travisg/6809obc/eagle/6809-layout.pdf

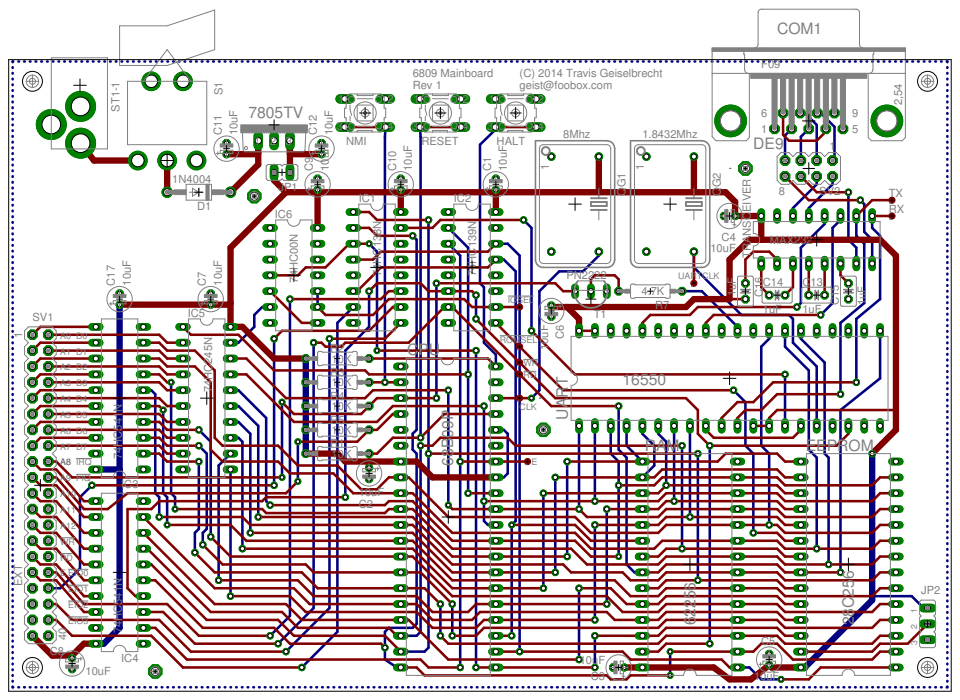
[picture p1: page 1]

R2
10K
R4
R5
