travisg/6809obc/eagle/6809-sch.pdf

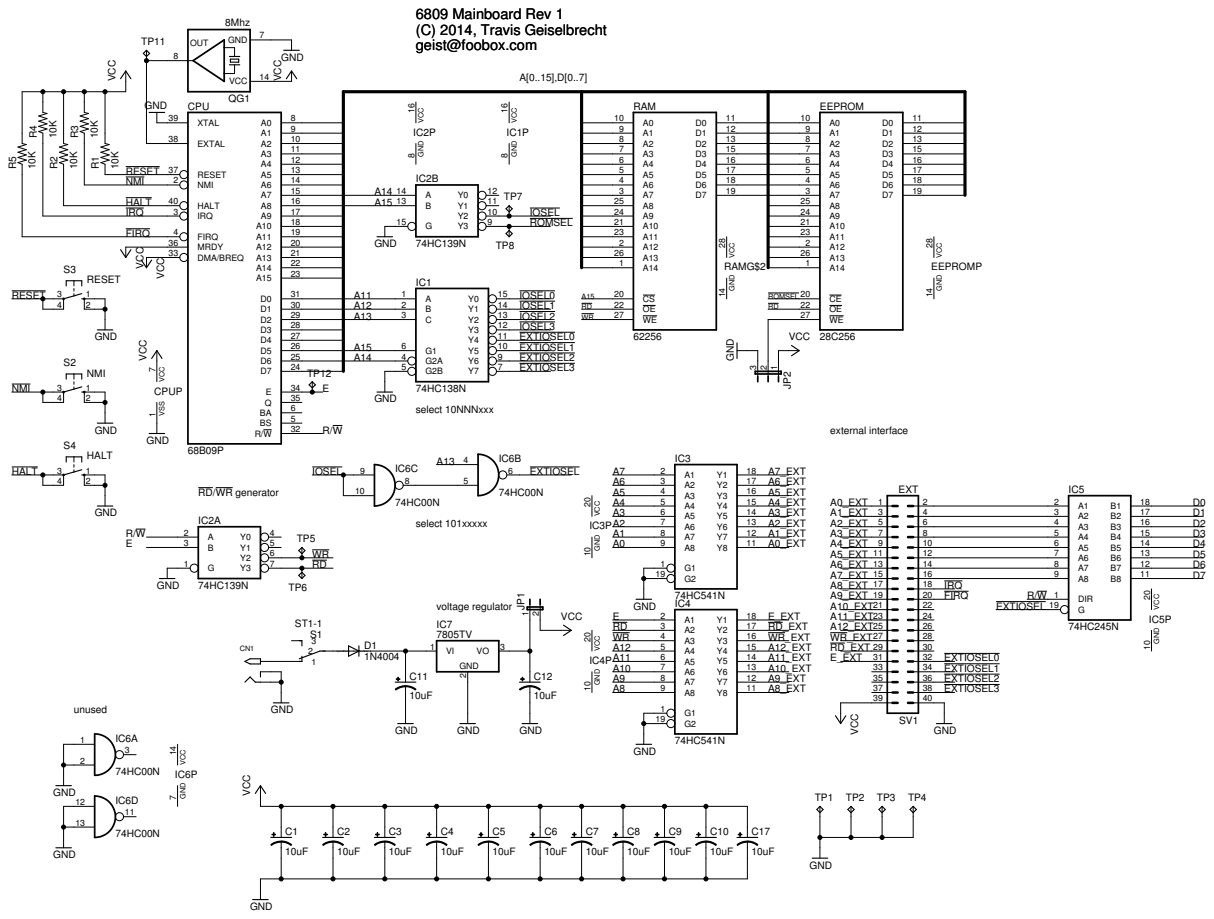
[picture p2: page 1]

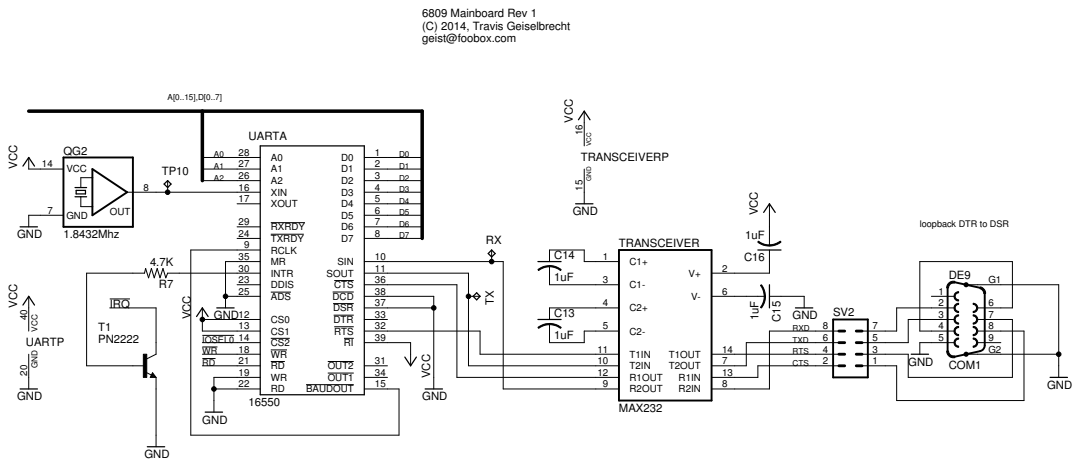
[picture p3: page 2]
