travisg/6809obc/eagle/6809.brd

## EAGLE design eagle/6809.brd (2014-07-19)

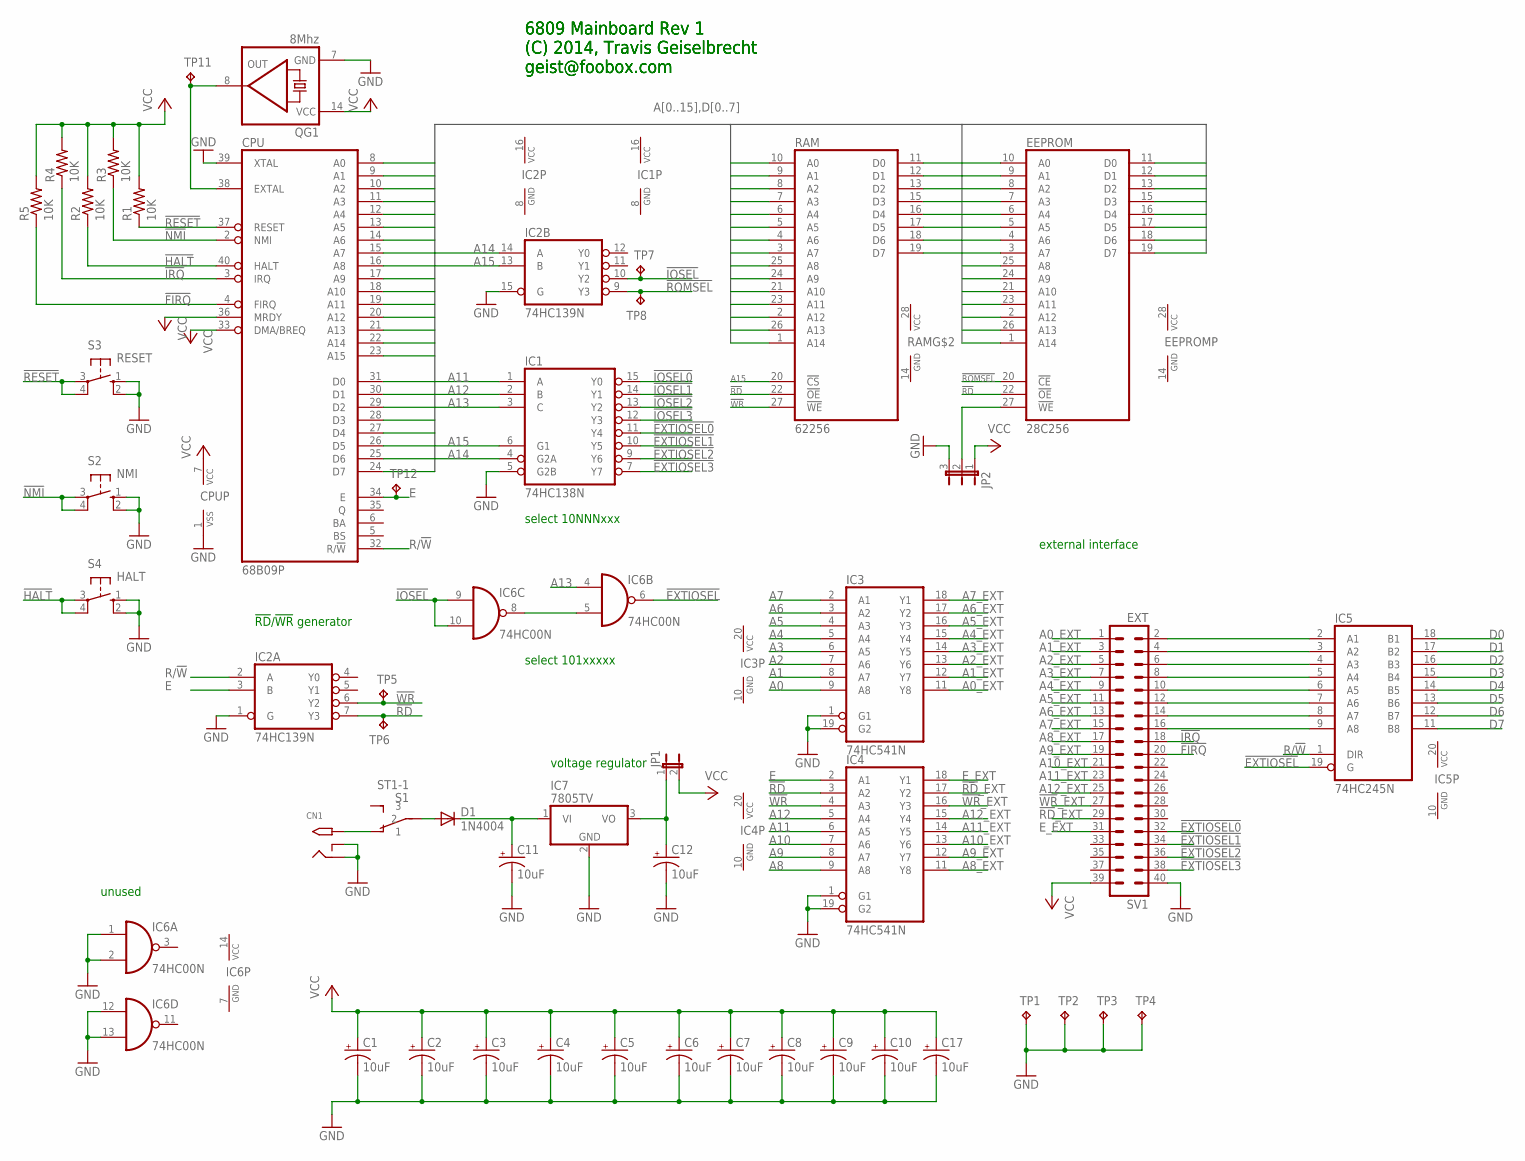
[picture p4: schematic 6809.sch, sheet 1]

Parts:
C1, C2, C3, C4, C5, C6, C7, C8, C9, C10, C11, C12, C17: 10uF; E1,8-4
CN1: 2.1MMJACKTHM; PJ-102A
CPU: 68B09P; DIL40
D1: 1N4004; DO41-10
EEPROM: 28C256; DIL28
IC1: 74HC138N; DIL16
IC2: 74HC139N; DIL16
IC3, IC4: 74HC541N; DIL20
IC5: 74HC245N; DIL20
IC6: 74HC00N; DIL14
IC7: 7805TV; TO220V
JP1: JP1E; JP1
JP2: JP2E; JP2
QG1: 8Mhz; DIL14S
R1, R2, R3, R4, R5: 10K; 0207/10
RAM: 62256; DIL28
S1: ST1-1
S2: NMI; B3F-10XX
S3: RESET; B3F-10XX
S4: HALT; B3F-10XX
SV1: EXT; MA20-2
TP1, TP2, TP3, TP4: TPPAD1-13; P1-13
TP5, TP6, TP7, TP8, TP11, TP12: TPTP10R; TP10R

Connections:
!EXTIOSEL: IC5.19 (G), IC6.6 (O)
!EXTIOSEL0: IC1.11 (Y4), SV1.32
!EXTIOSEL1: IC1.10 (Y5), SV1.34
!EXTIOSEL2: IC1.9 (Y6), SV1.36
!EXTIOSEL3: IC1.7 (Y7), SV1.38
!FIRQ: CPU.4 (FIRQ), R5.1, SV1.20
!HALT: CPU.40 (HALT), R2.1, S4.3, S4.4 (P1)
!IOSEL: IC2.10 (Y2), IC6.9 (I0), IC6.10 (I1), TP7.TP
!IOSEL0: IC1.15 (Y0); also elsewhere on the board
!IOSEL1: IC1.14 (Y1)
!IOSEL2: IC1.13 (Y2)
!IOSEL3: IC1.12 (Y3)
!IRQ: CPU.3 (IRQ), R4.1, SV1.18; also elsewhere on the board
!NMI: CPU.2 (NMI), R3.1, S2.3, S2.4 (P1)
!RD: EEPROM.22 (!OE), IC2.7 (Y3), IC4.3 (A2), RAM.22 (!OE), TP6.TP; also elsewhere on the board
!RD!_EXT: IC4.17 (Y2), SV1.29
!RESET: CPU.37 (RESET), R1.1, S3.3, S3.4 (P1)
!ROMSEL: EEPROM.20 (!CE), IC2.9 (Y3), TP8.TP
!WR: IC2.6 (Y2), IC4.4 (A3), RAM.27 (!WE), TP5.TP; also elsewhere on the board
!WR!_EXT: IC4.16 (Y3), SV1.27
A0: CPU.8 (A0), EEPROM.10 (A0), IC3.9 (A8), RAM.10 (A0); also elsewhere on the board
A0_EXT: IC3.11 (Y8), SV1.1
A1: CPU.9 (A1), EEPROM.9 (A1), IC3.8 (A7), RAM.9 (A1); also elsewhere on the board
A1_EXT: IC3.12 (Y7), SV1.3
A2: CPU.10 (A2), EEPROM.8 (A2), IC3.7 (A6), RAM.8 (A2); also elsewhere on the board
A2_EXT: IC3.13 (Y6), SV1.5
A3: CPU.11 (A3), EEPROM.7 (A3), IC3.6 (A5), RAM.7 (A3)
A3_EXT: IC3.14 (Y5), SV1.7
A4: CPU.12 (A4), EEPROM.6 (A4), IC3.5 (A4), RAM.6 (A4)
A4_EXT: IC3.15 (Y4), SV1.9
A5: CPU.13 (A5), EEPROM.5 (A5), IC3.4 (A3), RAM.5 (A5)
A5_EXT: IC3.16 (Y3), SV1.11
A6: CPU.14 (A6), EEPROM.4 (A6), IC3.3 (A2), RAM.4 (A6)
A6_EXT: IC3.17 (Y2), SV1.13
A7: CPU.15 (A7), EEPROM.3 (A7), IC3.2 (A1), RAM.3 (A7)
A7_EXT: IC3.18 (Y1), SV1.15
A8: CPU.16 (A8), EEPROM.25 (A8), IC4.9 (A8), RAM.25 (A8)
A8_EXT: IC4.11 (Y8), SV1.17
A9: CPU.17 (A9), EEPROM.24 (A9), IC4.8 (A7), RAM.24 (A9)
A9_EXT: IC4.12 (Y7), SV1.19
A10: CPU.18 (A10), EEPROM.21 (A10), IC4.7 (A6), RAM.21 (A10)
A10_EXT: IC4.13 (Y6), SV1.21
A11: CPU.19 (A11), EEPROM.23 (A11), IC1.1 (A), IC4.6 (A5), RAM.23 (A11)
A11_EXT: IC4.14 (Y5), SV1.23
A12: CPU.20 (A12), EEPROM.2 (A12), IC1.2 (B), IC4.5 (A4), RAM.2 (A12)
A12_EXT: IC4.15 (Y4), SV1.25
A13: CPU.21 (A13), EEPROM.26 (A13), IC1.3 (C), IC6.4 (I0), RAM.26 (A13)
A14: CPU.22 (A14), EEPROM.1 (A14), IC1.4 (G2A), IC2.14 (A), RAM.1 (A14)
A15: CPU.23 (A15), IC1.6 (G1), IC2.13 (B), RAM.20 (!CS)
D0: CPU.31 (D0), EEPROM.11 (D0), IC5.18 (B1), RAM.11 (D0); also elsewhere on the board
D1: CPU.30 (D1), EEPROM.12 (D1), IC5.17 (B2), RAM.12 (D1); also elsewhere on the board
D2: CPU.29 (D2), EEPROM.13 (D2), IC5.16 (B3), RAM.13 (D2); also elsewhere on the board
D3: CPU.28 (D3), EEPROM.15 (D3), IC5.15 (B4), RAM.15 (D3); also elsewhere on the board
D4: CPU.27 (D4), EEPROM.16 (D4), IC5.14 (B5), RAM.16 (D4); also elsewhere on the board
D5: CPU.26 (D5), EEPROM.17 (D5), IC5.13 (B6), RAM.17 (D5); also elsewhere on the board
D6: CPU.25 (D6), EEPROM.18 (D6), IC5.12 (B7), RAM.18 (D6); also elsewhere on the board
D7: CPU.24 (D7), EEPROM.19 (D7), IC5.11 (B8), RAM.19 (D7); also elsewhere on the board
E: CPU.34 (E), IC2.3 (B), IC4.2 (A1), TP12.TP
E_EXT: IC4.18 (Y1), SV1.31
GND: C1.-, C2.-, C3.-, C4.-, C5.-, C6.-, C7.-, C8.-, C9.-, C10.-, C11.-, C12.-, C17.-, CN1.RING, CN1.RING_SW, CPU.1 (VSS), CPU.39 (XTAL), EEPROM.14 (GND), IC1.5 (G2B), IC1.8 (GND), IC2.1 (G), IC2.8 (GND), IC2.15 (G), IC3.1 (G1), IC3.10 (GND), IC3.19 (G2), IC4.1 (G1), IC4.10 (GND), IC4.19 (G2), IC5.10 (GND), IC6.1 (I0), IC6.2 (I1), IC6.7 (GND), IC6.12 (I0), IC6.13 (I1), IC7.2 (GND), JP2.3, QG1.7 (GND), RAM.14 (GND), S2.1 (S), S2.2 (S1), S3.1 (S), S3.2 (S1), S4.1 (S), S4.2 (S1), SV1.40, TP1.TP, TP2.TP, TP3.TP, TP4.TP; also elsewhere on the board
unnamed: C11.+, D1.C, IC7.1 (VI)
unnamed: IC6.5 (I1), IC6.8 (O)
unnamed: CN1.TIP, S1.P$1 (1)
unnamed: CPU.38 (EXTAL), QG1.8 (OUT), TP11.TP
unnamed: D1.A, S1.P$2 (2)
unnamed: EEPROM.27 (!WE), JP2.2
unnamed: C12.+, IC7.3 (VO), JP1.1
unnamed: IC5.2 (A1), SV1.2
unnamed: IC5.3 (A2), SV1.4
unnamed: IC5.4 (A3), SV1.6
unnamed: IC5.5 (A4), SV1.8
unnamed: IC5.6 (A5), SV1.10
unnamed: IC5.7 (A6), SV1.12
unnamed: IC5.8 (A7), SV1.14
unnamed: IC5.9 (A8), SV1.16
R/!W: CPU.32 (R/!W), IC2.2 (A), IC5.1 (DIR)
VCC: C1.+, C2.+, C3.+, C4.+, C5.+, C6.+, C7.+, C8.+, C9.+, C10.+, C17.+, CPU.7 (VCC), CPU.33 (DMA/BREQ), CPU.36 (MRDY), EEPROM.28 (VCC), IC1.16 (VCC), IC2.16 (VCC), IC3.20 (VCC), IC4.20 (VCC), IC5.20 (VCC), IC6.14 (VCC), JP1.2, JP2.1, QG1.14 (VCC), R1.2, R2.2, R3.2, R4.2, R5.2, RAM.28 (VCC), SV1.39; also elsewhere on the board

Notes on the sheet:
!RD!/!WR! generator
external interface
select 10NNNxxx
select 101xxxxx
voltage regulator
unused
6809 Mainboard Rev 1 (C) 2014, Travis Geiselbrecht geist@foobox.com

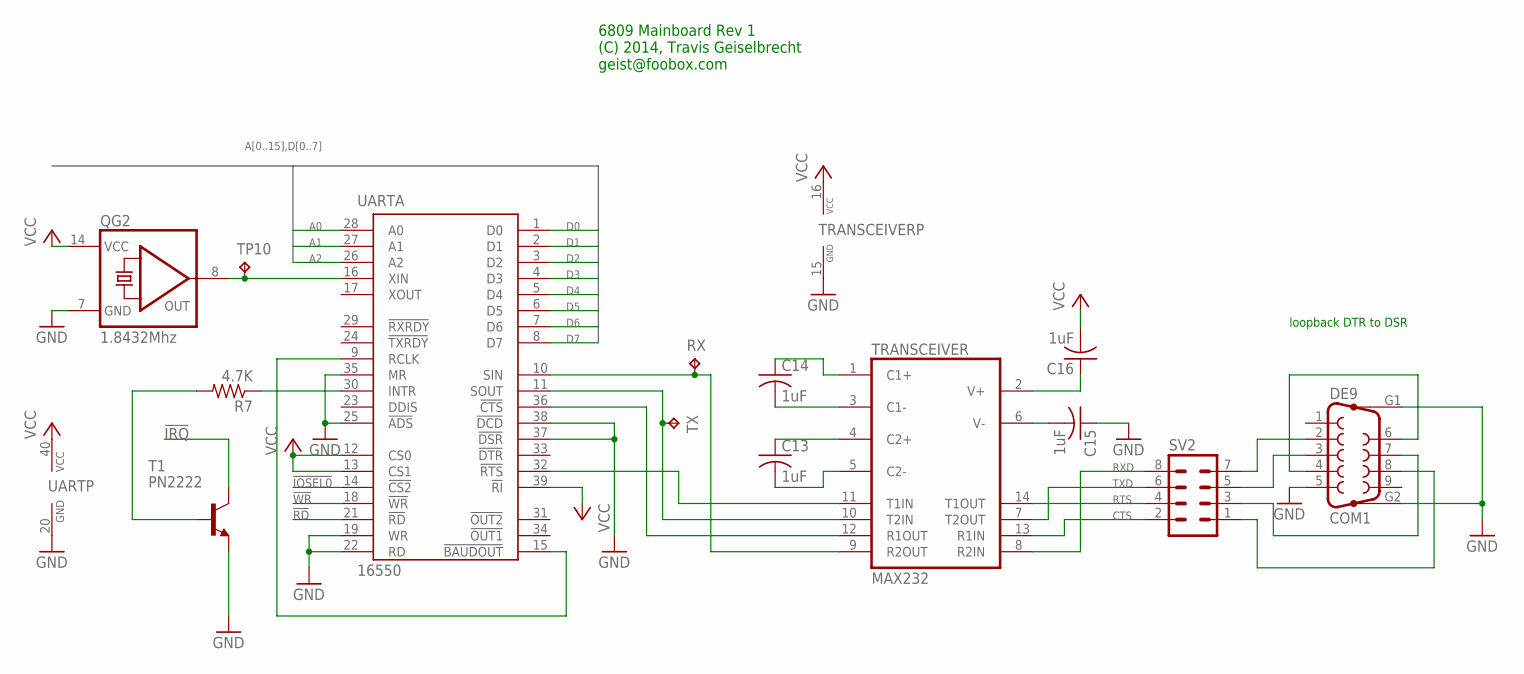
[picture p5: schematic 6809.sch, sheet 2]

Parts:
C13, C14, C15, C16: 1uF; C025-025X050
DE9: COM1; F09HP
QG2: 1.8432Mhz; DIL14S
R7: 4.7K; 0207/10
RX: TPTP10R; TP10R
SV2: MA04-2
T1: PN2222; TO92-EBC-OVAL
TP10: TPTP10R; TP10R
TRANSCEIVER: MAX232; DIL16
TX: TPTP10R; TP10R
UART: 16550; DIL40

Connections:
!IOSEL0: UART.14 (!CS2); also elsewhere on the board
!IRQ: T1.C; also elsewhere on the board
!RD: UART.21 (!RD); also elsewhere on the board
!WR: UART.18 (!WR); also elsewhere on the board
A0: UART.28 (A0); also elsewhere on the board
A1: UART.27 (A1); also elsewhere on the board
A2: UART.26 (A2); also elsewhere on the board
CTS: SV2.2, TRANSCEIVER.13 (R1IN)
D0: UART.1 (D0); also elsewhere on the board
D1: UART.2 (D1); also elsewhere on the board
D2: UART.3 (D2); also elsewhere on the board
D3: UART.4 (D3); also elsewhere on the board
D4: UART.5 (D4); also elsewhere on the board
D5: UART.6 (D5); also elsewhere on the board
D6: UART.7 (D6); also elsewhere on the board
D7: UART.8 (D7); also elsewhere on the board
GND: C15.1, DE9.5, DE9.G1, DE9.G2, QG2.7 (GND), T1.E, TRANSCEIVER.15 (GND), UART.19 (WR), UART.20 (GND), UART.22 (RD), UART.25 (!ADS), UART.35 (MR), UART.37 (!DSR), UART.38 (!DCD); also elsewhere on the board
unnamed: QG2.8 (OUT), TP10.TP, UART.16 (XIN)
unnamed: TRANSCEIVER.11 (T1IN), UART.32 (!RTS)
unnamed: TRANSCEIVER.10 (T2IN), TX.TP, UART.11 (SOUT)
unnamed: TRANSCEIVER.12 (R1OUT), UART.36 (!CTS)
unnamed: DE9.4, DE9.6
unnamed: C14.1, TRANSCEIVER.1 (C1+)
unnamed: C14.2, TRANSCEIVER.3 (C1-)
unnamed: RX.TP, TRANSCEIVER.9 (R2OUT), UART.10 (SIN)
unnamed: C13.1, TRANSCEIVER.4 (C2+)
unnamed: C13.2, TRANSCEIVER.5 (C2-)
unnamed: DE9.2, SV2.7
unnamed: DE9.3, SV2.5
unnamed: DE9.7, SV2.3
unnamed: C16.1, TRANSCEIVER.2 (V+)
unnamed: DE9.8, SV2.1
unnamed: C15.2, TRANSCEIVER.6 (V-)
unnamed: R7.2, T1.B
unnamed: R7.1, UART.30 (INTR)
unnamed: UART.9 (RCLK), UART.15 (!BAUDOUT)
RTS: SV2.4, TRANSCEIVER.14 (T1OUT)
RXD: SV2.8, TRANSCEIVER.8 (R2IN)
TXD: SV2.6, TRANSCEIVER.7 (T2OUT)
VCC: C16.2, QG2.14 (VCC), TRANSCEIVER.16 (VCC), UART.12 (CS0), UART.13 (CS1), UART.39 (!RI), UART.40 (VCC); also elsewhere on the board

Notes on the sheet:
loopback DTR to DSR
6809 Mainboard Rev 1 (C) 2014, Travis Geiselbrecht geist@foobox.com

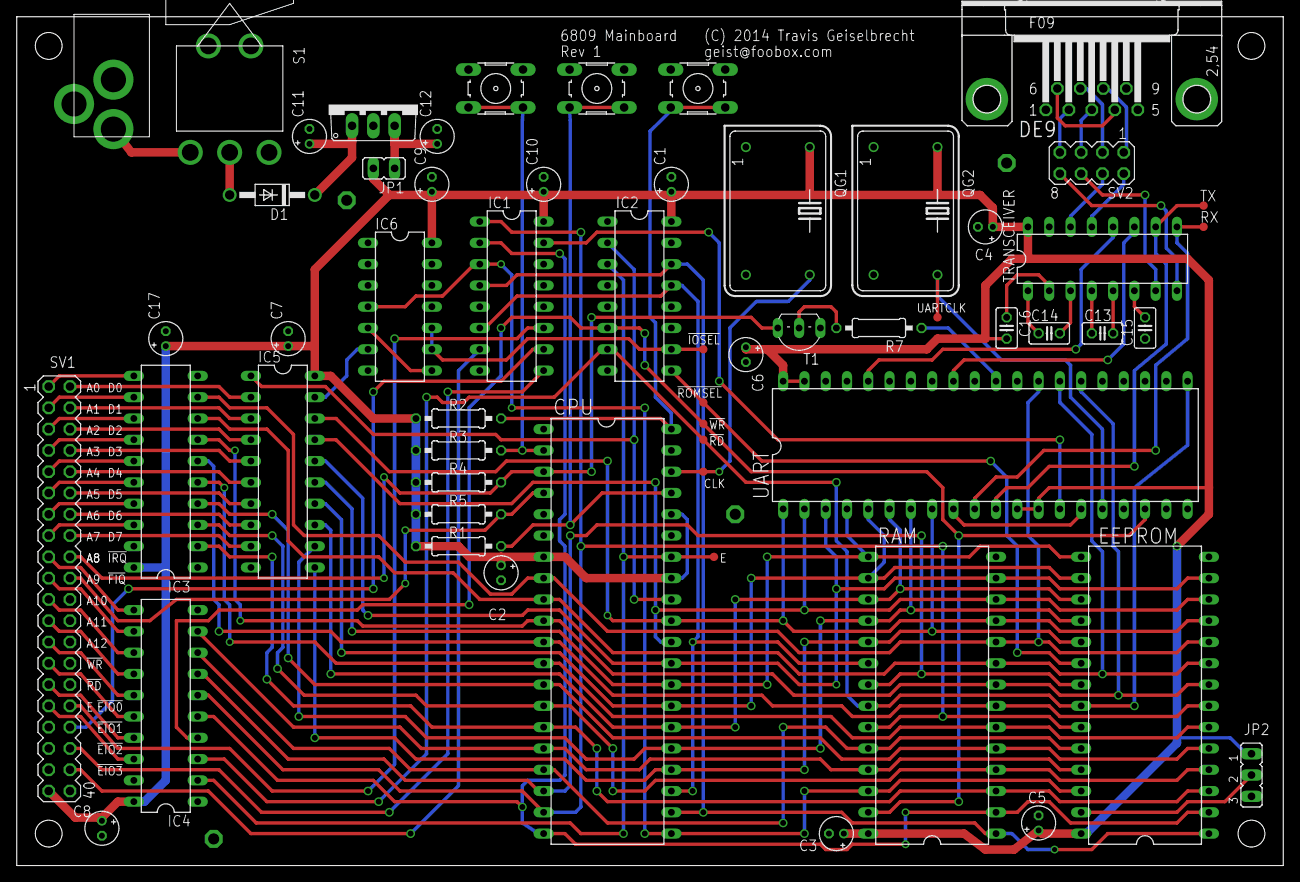
[picture p6: board 6809.brd from above]

Board: 2 copper layers, 151.1 x 101.3 mm, 62 parts (0 on the bottom side), 97 nets.
