travisg/6809obc/rom_c/stdint.h

/*
 * Copyright (c) 2008-2014 Travis Geiselbrecht
 *
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
 * THE SOFTWARE IS PROVIDED "AS IS", WITHOUT WARRANTY OF ANY KIND,
 * EXPRESS OR IMPLIED, INCLUDING BUT NOT LIMITED TO THE WARRANTIES OF
 * MERCHANTABILITY, FITNESS FOR A PARTICULAR PURPOSE AND NONINFRINGEMENT.
 * IN NO EVENT SHALL THE AUTHORS OR COPYRIGHT HOLDERS BE LIABLE FOR ANY
 * CLAIM, DAMAGES OR OTHER LIABILITY, WHETHER IN AN ACTION OF CONTRACT,
 * TORT OR OTHERWISE, ARISING FROM, OUT OF OR IN CONNECTION WITH THE
 * SOFTWARE OR THE USE OR OTHER DEALINGS IN THE SOFTWARE.
 */
#pragma once

#include <limits.h> // for ULONG_MAX

typedef unsigned char      uint8_t;
typedef unsigned int       uint16_t;
typedef unsigned long      uint32_t;
typedef signed char        int8_t;
typedef int                int16_t;
typedef long               int32_t;

#define INT8_MIN    CHAR_MIN
#define INT16_MIN   INT_MIN
#define INT32_MIN   LONG_MIN

#if 0
#if defined(LLONG_MIN)
#define INT64_MIN   LLONG_MIN
#elif defined(__LONG_LONG_MAX__)
#define INT64_MIN (-__LONG_LONG_MAX__-1LL)
#endif
#endif

#define INT8_MAX    CHAR_MAX
#define INT16_MAX   INT_MAX
#define INT32_MAX   LONG_MAX

#if 0
#if defined(LLONG_MAX)
#define INT64_MAX   LLONG_MAX
#elif defined(__LONG_LONG_MAX__)
#define INT64_MAX  __LONG_LONG_MAX__
#endif
#endif

#define UINT8_MAX   UCHAR_MAX
#define UINT16_MAX  UINT_MAX
#define UINT32_MAX  ULONG_MAX

#if 0
#if defined(ULLONG_MAX)
#define UINT64_MAX  ULLONG_MAX
#elif defined(__LONG_LONG_MAX__)
#define UINT64_MAX (__LONG_LONG_MAX__*2ULL + 1ULL)
#endif
#endif

typedef int8_t int_least8_t;
typedef int16_t int_least16_t;
typedef int32_t int_least32_t;
//typedef int64_t int_least64_t;
typedef uint8_t uint_least8_t;
typedef uint16_t uint_least16_t;
typedef uint32_t uint_least32_t;
//typedef uint64_t uint_least64_t;

#define INT_LEAST8_MIN  INT8_MIN
#define INT_LEAST16_MIN INT16_MIN
#define INT_LEAST32_MIN INT32_MIN
//#define INT_LEAST64_MIN INT64_MIN
#define INT_LEAST8_MAX  INT8_MAX
#define INT_LEAST16_MAX INT16_MAX
#define INT_LEAST32_MAX INT32_MAX
//#define INT_LEAST64_MAX INT64_MAX

#define UINT_LEAST8_MAX  UINT8_MAX
#define UINT_LEAST16_MAX UINT16_MAX
#define UINT_LEAST32_MAX UINT32_MAX
//#define UINT_LEAST64_MAX UINT64_MAX

typedef int8_t int_fast8_t;
typedef int16_t int_fast16_t;
typedef int32_t int_fast32_t;
//typedef int64_t int_fast64_t;
typedef uint8_t uint_fast8_t;
typedef uint16_t uint_fast16_t;
typedef uint32_t uint_fast32_t;
//typedef uint64_t uint_fast64_t;

#define INT_FAST8_MIN  INT8_MIN
#define INT_FAST16_MIN INT16_MIN
#define INT_FAST32_MIN INT32_MIN
//#define INT_FAST64_MIN INT64_MIN
#define INT_FAST8_MAX  INT8_MAX
#define INT_FAST16_MAX INT16_MAX
#define INT_FAST32_MAX INT32_MAX
//#define INT_FAST64_MAX INT64_MAX

#define UINT_FAST8_MAX  UINT8_MAX
#define UINT_FAST16_MAX UINT16_MAX
#define UINT_FAST32_MAX UINT32_MAX
//#define UINT_FAST64_MAX UINT64_MAX

typedef int intptr_t;
typedef unsigned int uintptr_t;

#define INTPTR_MIN        INT_MIN
#define INTPTR_MAX        INT_MAX
#define UINTPTR_MAX       UINT_MAX

typedef long intmax_t;
typedef unsigned long uintmax_t;

#define INTMAX_MAX        LONG_MAX
#define INTMAX_MIN        LONG_MIN
#define UINTMAX_MAX       ULONG_MAX

#define SIZE_MAX INT_MAX

#define INT8_C(c)         (c)
#define INT16_C(c)        (c)
#define INT32_C(c)        (c)
//#define INT64_C(c)        (c ## LL)

#define UINT8_C(c)        (c)
#define UINT16_C(c)       (c)
#define UINT32_C(c)       (c ## U)
//#define UINT64_C(c)       (c ## ULL)

#define INTMAX_C(c)       INT32_C(c)
#define UINTMAX_C(c)      UINT32_C(c)
