travisg/6809obc/(commit log)

2014-07-19 revision 1 of the 6809 one board computer eagle cad files
    [6809.brd, 6809.sch]
2014-07-26 add .gitignore for eagle cad stuff
2017-12-31 WIP switch to monitor to using a tokenizer
